fanxinyusarah/performingrobots/images/8_motor_holder_sketch.jpg

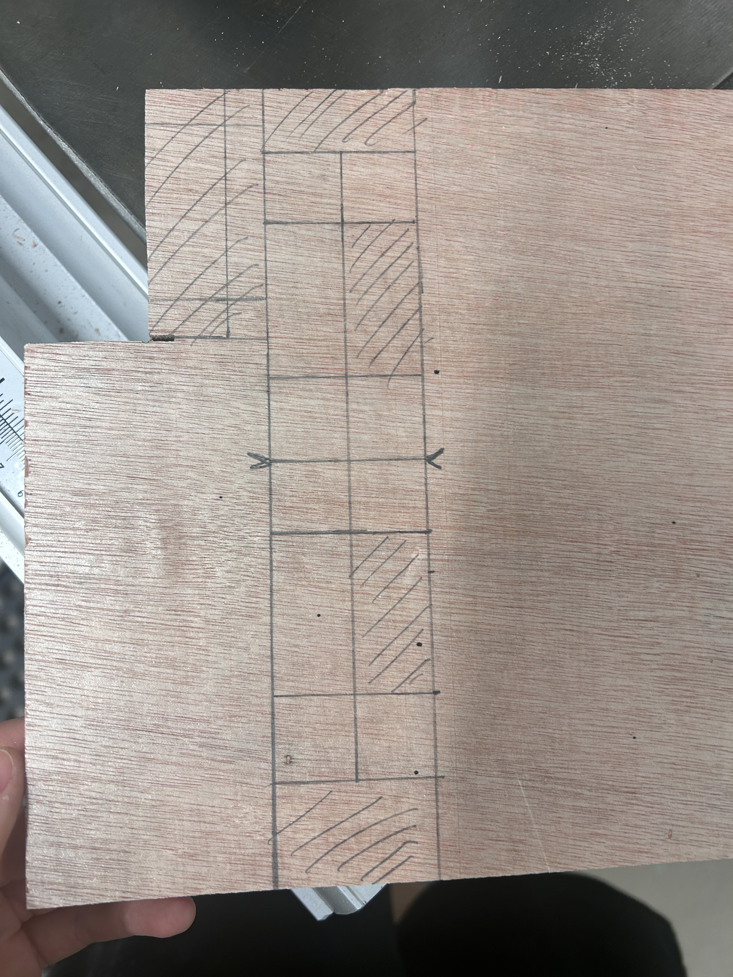
[picture p7: images/8_motor_holder_sketch.jpg]
images/8_motor_holder_sketch.jpg
