fanxinyusarah/performingrobots/images/9_holder_cut_try.jpg

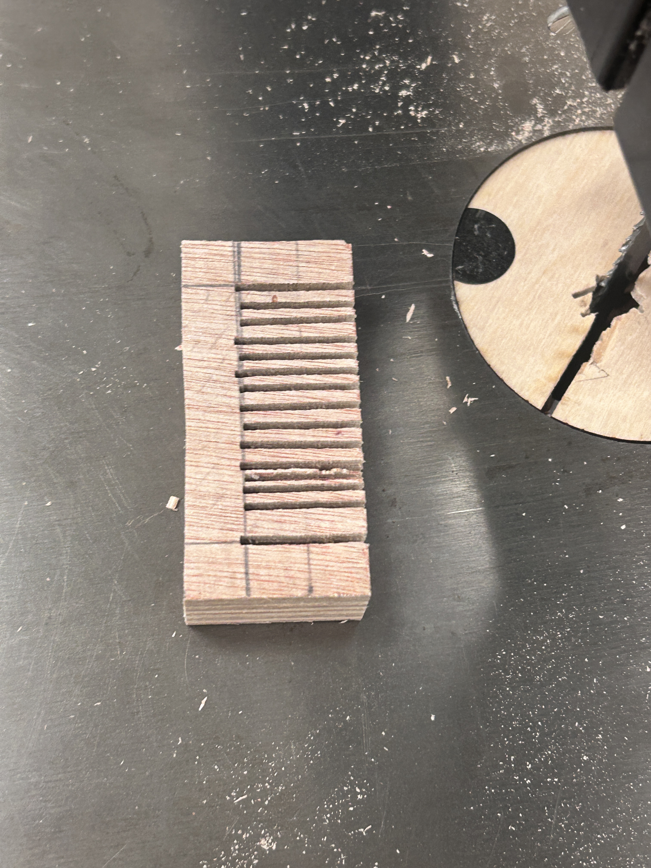
[picture p8: images/9_holder_cut_try.jpg]
images/9_holder_cut_try.jpg
