fanxinyusarah/performingrobots/images/11_holder_and_base_support.jpg

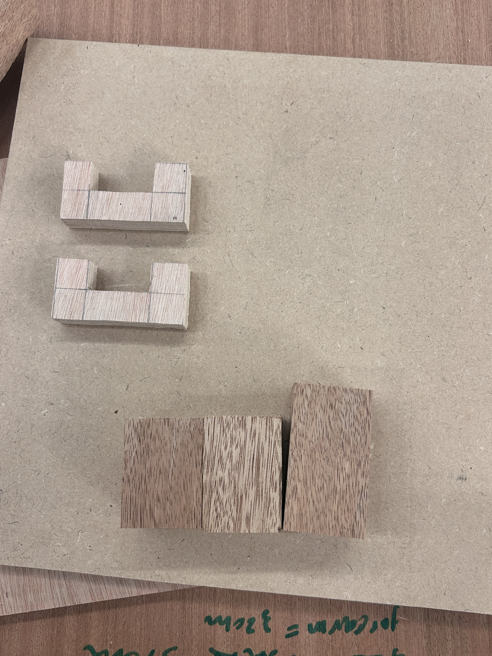
[picture p10: images/11_holder_and_base_support.jpg]
images/11_holder_and_base_support.jpg
