fanxinyusarah/performingrobots/images/12_motor_attached_front.jpg

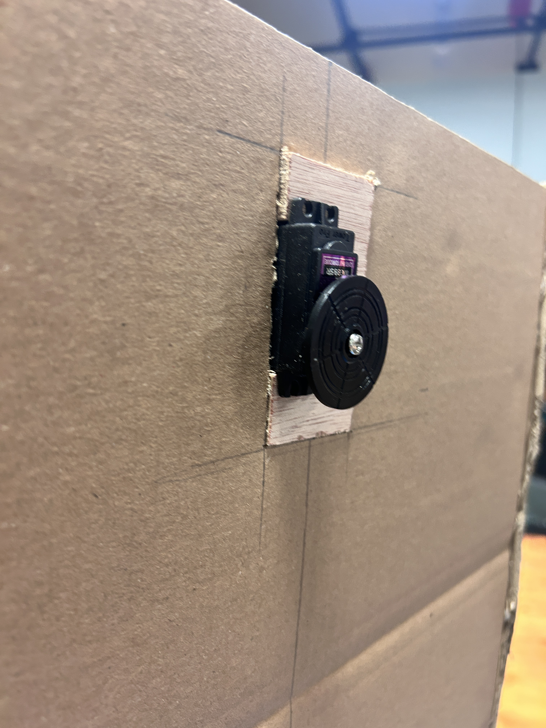
[picture p11: images/12_motor_attached_front.jpg]
images/12_motor_attached_front.jpg
