fanxinyusarah/performingrobots/images/37_full_hammar.jpg

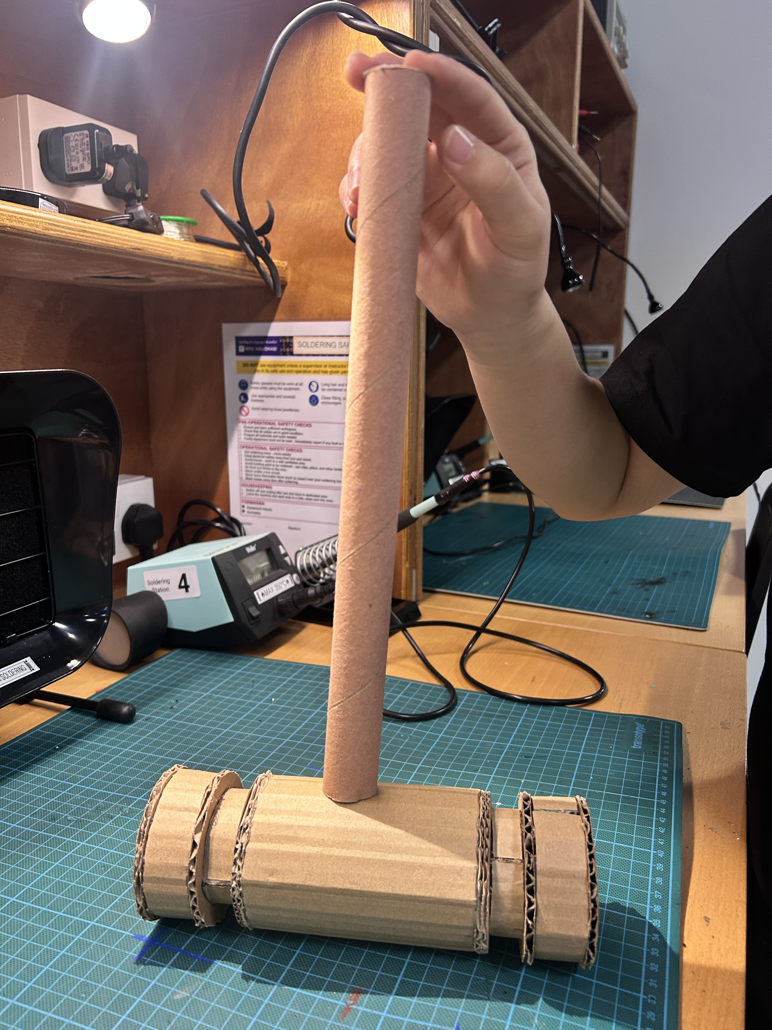
[picture p36: images/37_full_hammar.jpg]
images/37_full_hammar.jpg
