fanxinyusarah/performingrobots/images/41_test_eye.jpg

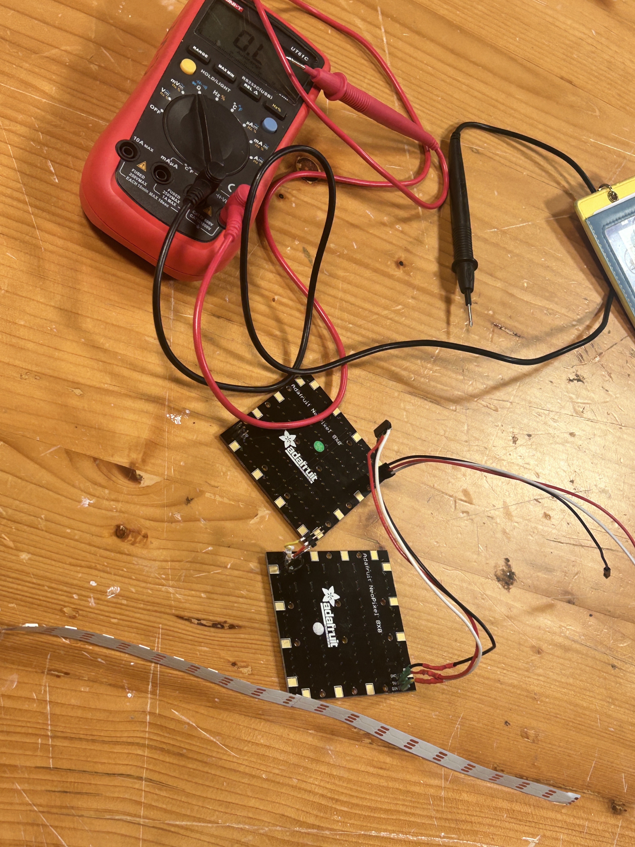
[picture p40: images/41_test_eye.jpg]
images/41_test_eye.jpg
