fanxinyusarah/performingrobots/images/42_led_eye.jpg

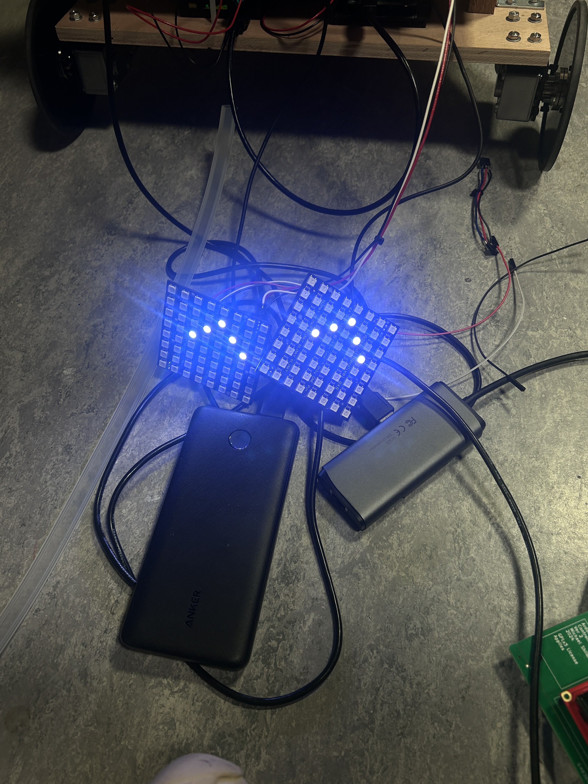
[picture p41: images/42_led_eye.jpg]
images/42_led_eye.jpg
