fanxinyusarah/performingrobots/images/43_led_strip_light.jpg

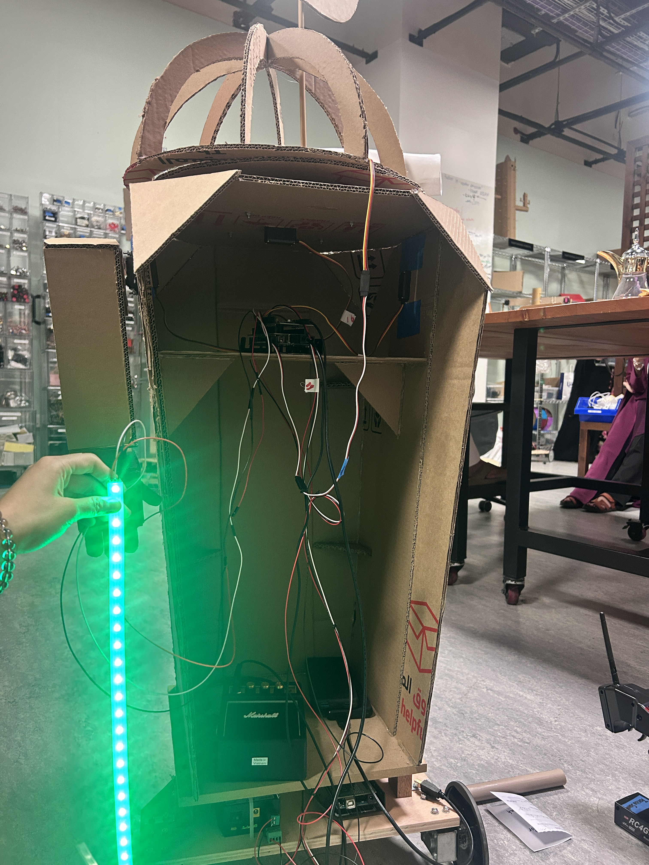
[picture p42: images/43_led_strip_light.jpg]
images/43_led_strip_light.jpg
