fanxinyusarah/performingrobots/images/49_eye_holder_attached.jpg

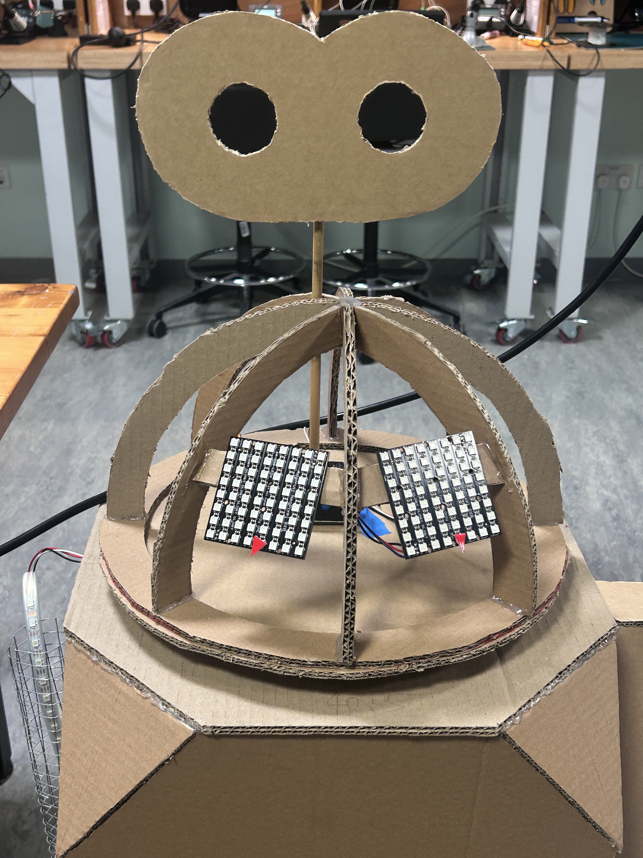
[picture p48: images/49_eye_holder_attached.jpg]
images/49_eye_holder_attached.jpg
