fanxinyusarah/performingrobots/images/51_body_painted.jpg

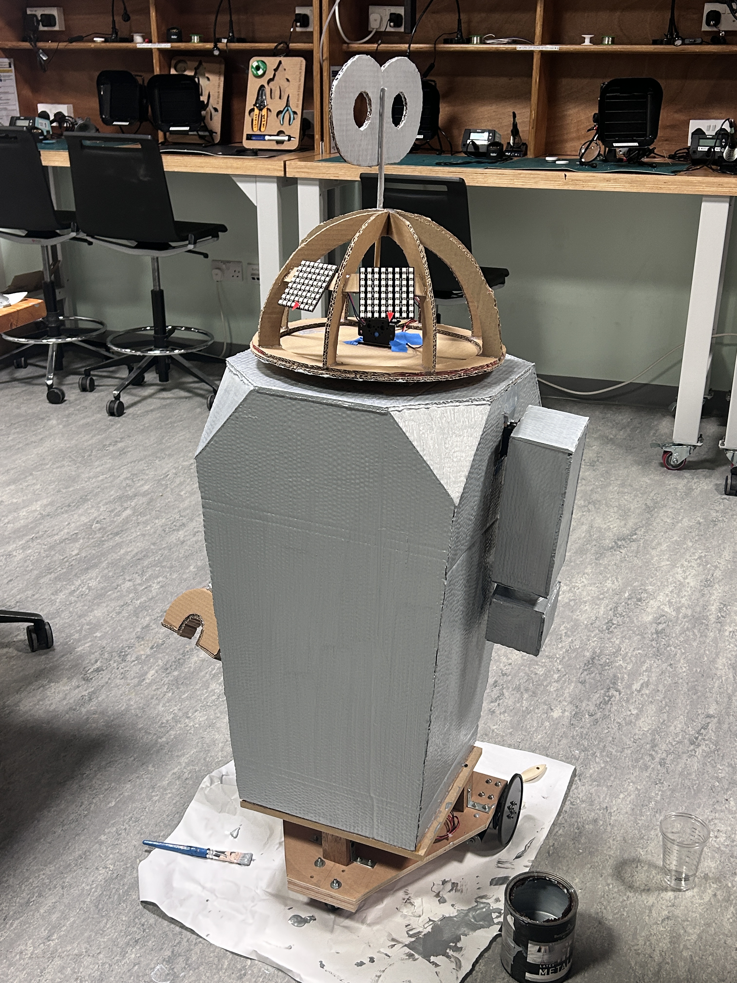
[picture p50: images/51_body_painted.jpg]
images/51_body_painted.jpg
