fanxinyusarah/performingrobots/images/54_wire_from_head.jpg

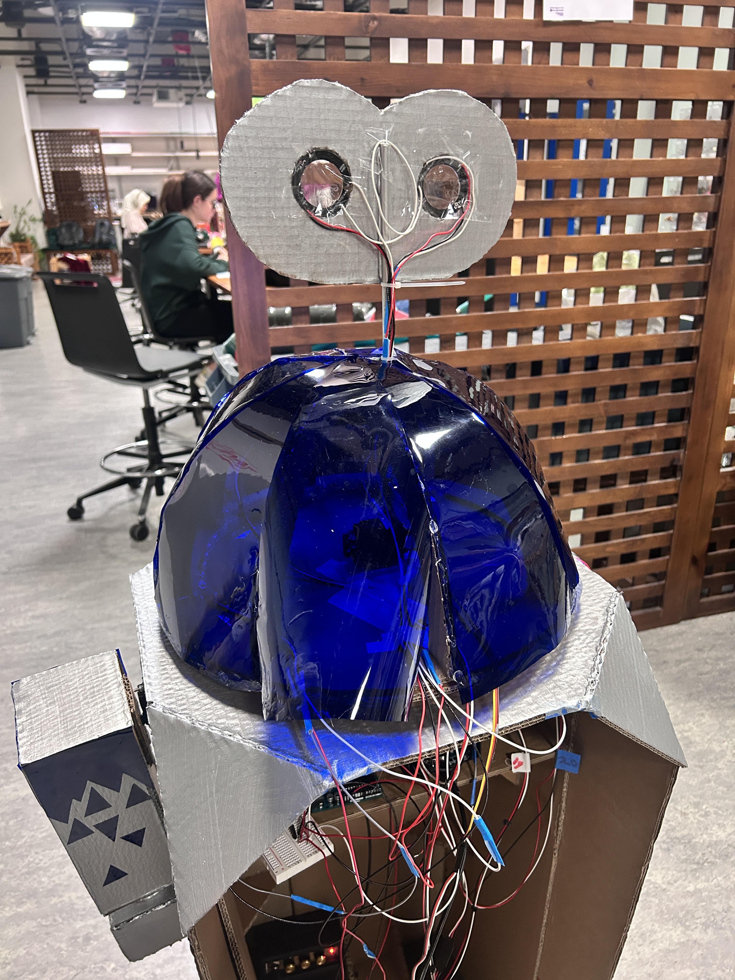
[picture p53: images/54_wire_from_head.jpg]
images/54_wire_from_head.jpg
