fanxinyusarah/performingrobots/images/56_robot_finished_drawing.jpg

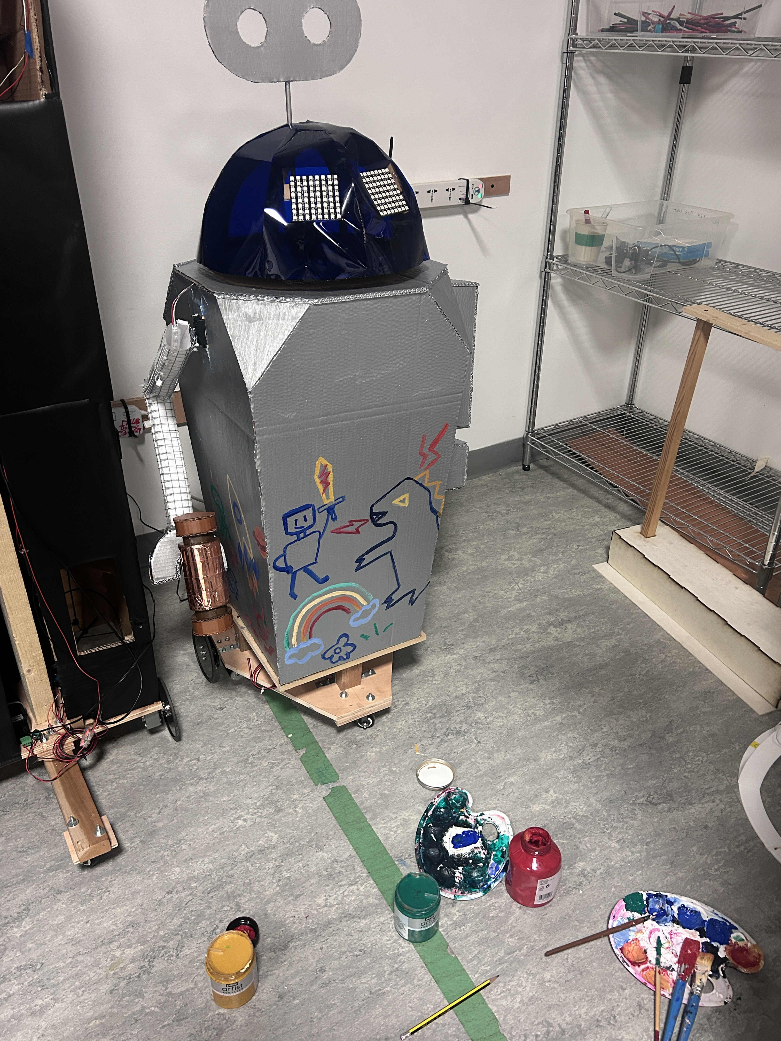
[picture p54: images/56_robot_finished_drawing.jpg]
images/56_robot_finished_drawing.jpg
